ZegarNotAvailable/Easy-EEPROM-programmer/KM2864/README.MD

# Program for CA80.
- LADR is only for display current address.
- HALT is used for delay 2 ms. (NMI is called evry 2 ms)
- Read datasheet of yours EEPROM.
