ZegarNotAvailable/Easy-EEPROM-programmer/Pictures/TWC.png

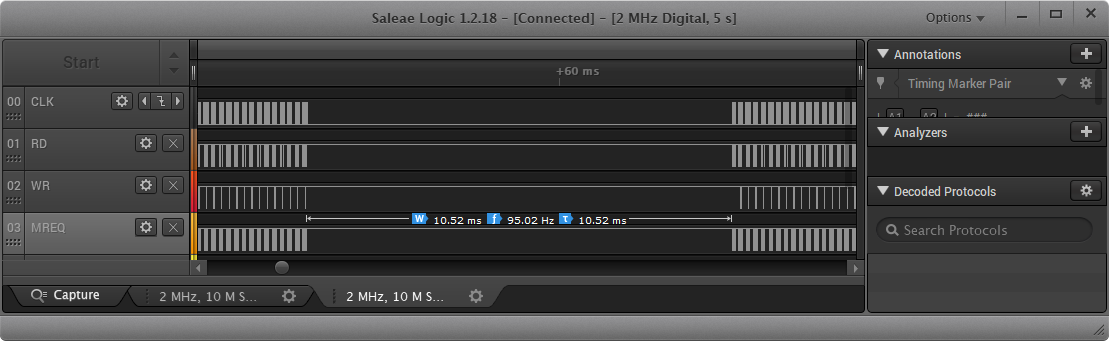
Pictures/TWC.png
